LnBdd/hyberflow/index.md

---
title: Mainpage
nav_order: 1
---

<p align="center">
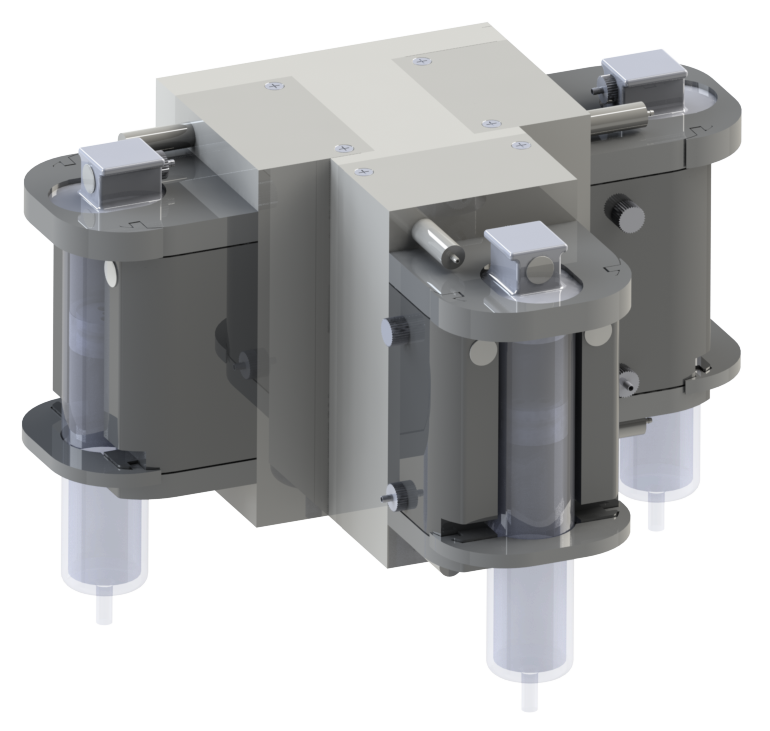
[picture p1: images/banner/Print_Head.png]
  
</p>

# HYBERFLOW - a novel hydraulically actuated open source bioextrusion printhead

HYBERFLOW is an printhead for bioextrusion applications and was developed at the Leibniz Universität Hannover by the [Institute for Mechatronic Systems](https://www.imes.uni-hannover.de/en/). 

This documentation enables you to rebuild the system and integrate it in your bioprinter setup. We provide an example code to interface the module through a serial commincation. Since the control of the actual extrusion of the module is done by an onboard microcontroller, mulitple modules can be interfaced and operated simultaniously. 

## Citing

The HYBERFLOW was first presented and evaluated in an [Bioprinting paper](https://www.sciencedirect.com/science/article/pii/S240588662500051X) in 2025, which is freely available. If you use parts of this project for your reserach, please cite the publication:
```
Leon Budde, Julia Hundertmark, Tim Meyer, Thomas Seel, Daniel O.M. Weber,
HYBERFLOW — enabling non-invasive flow rate feedback control in bioprinting via hydraulic actuation,
Bioprinting, Volume 50, 2025,
e00435,
ISSN 2405-8866,
https://doi.org/10.1016/j.bprint.2025.e00435.
```

## Further Publications

There are also further publication of our bioprinting and automation projects:
- [EMBC 2025 Camera-based In-Process Evaluation and Parameter Study of Core-Shell-Capsule Dimensions]()
- [CDBME 2024 Core-Shell Capsule Image Segmentation through Deep Learning with Synthetic Training Data](https://doi.org/10.1515/cdbme-2024-2030)
- [SLAS Tech 2024 CrocoGrip](https://doi.org/10.1016/j.slast.2024.100148)
- [CDBME 2022 A Six Degree of Freedom Bioprinter](https://www.degruyter.com/document/doi/10.1515/cdbme-2022-1036/html)
- more to come!

## Authors

HYBERFLOW is part of the PhD thesis of [Leon Budde](https://www.imes.uni-hannover.de/en/institut/team/m-sc-leon-budde)
(Email: <leon.budde@imes.uni-hannover.de>) and was developed with support from the IMES staff and supervised students.
