LnBdd/hyberflow/docs/Electronics.md

---
title: Electronics
parent: Assembly
nav_order: 1
---

<p align="left">
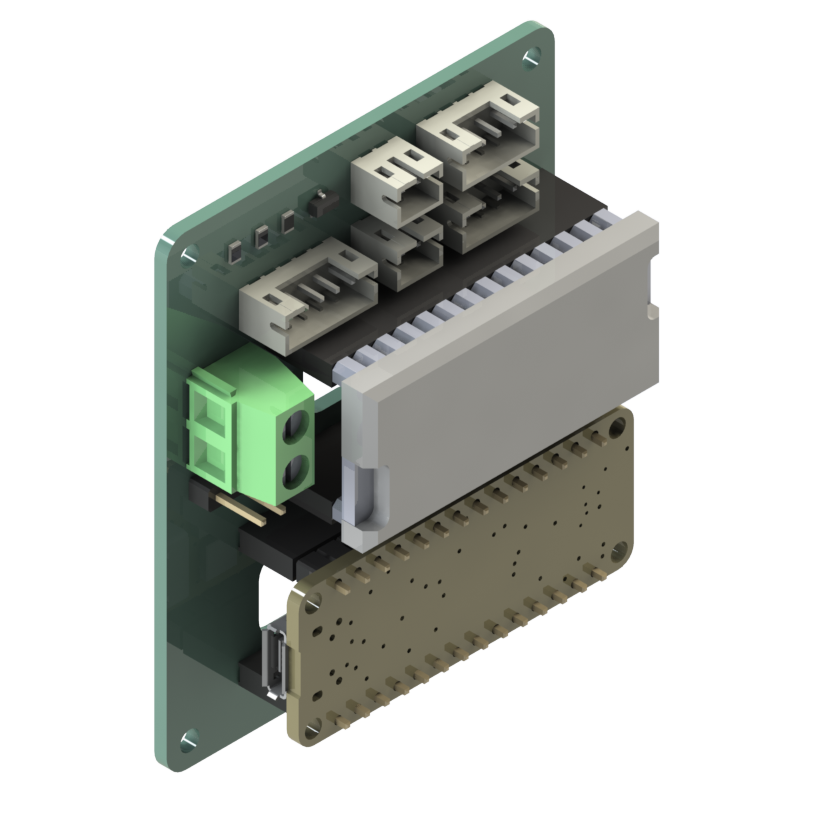
[picture p2: images/electronics/PCB_Iso.png]
  
</p>

<!-- Table of Contents -->
# Electronics
{: .no_toc }

## Table of Contents
{: .no_toc .text-delta }

1. TOC
{:toc}

{: .note }
The PCB can be downloaded [here](./Downloads/).

---

## Bill of Materials for PCB assembly

### Off-the-Shelf Components

| Part | Qty. | Manufacturer | Description / Value | Package | Type |
|---|---|---|---|---|---|
| Resistor | 3 | any | 4k7 | 805 | SMD |
| Connector | 2 | JST | B2B-PH-K-S | PH | THT |
| Connector | 2 | JST | PHR-2 | PH | THT |
| Connector | 1 | JST | PHR-3 | PH | THT |
| Connector | 2 | JST | B4B-PH-K-S | PH | THT |
| Connector | 2 | JST | PHR-4 | PH | THT |
| Connector | 1 | JST | B5B-PH-K-S | PH | THT |
| Connector | 1 | JST | PHR-5 | PH | THT |
| Crimp contact | 50 | JST | BPH-002T-P0.5S | PH | - |
| Connector | 1 | TE-Connectivity | 282836-2 | - | THT |
| MOSFET | 1 | ALPHA & OMEGA | AO3400A | SOT-32  | SMD |
| Pin Socket | 4 | any | 1×14 pin socket, 2.54mm pitch, vertical, 8.5mm height | - | THT |
| Pin Hocket | 1 | any | 1×02 pin header, 2.54mm pitch, vertical | - | THT |
| Jumper | 1 | any | 1×02 jumper, 2.54mm pitch, vertical | - | - |
| Wire | - | any | 0.25mm², different colors | - | - |
| Cable | 1 | Molex | Molex Picoblade 15134-0606 | - | - |

{: .note }
All other electrical components are listed [here](./ActuationUnit.md).

---

## PCB

### Schematics
<object data="../images/electronics/hyberflow_PCB_v1-2.pdf" width="800" height="600" type='application/pdf'></object>

### Pinout
<p align="center">
  
</p>

### Assembly 
For PCB assembly use the [interactive instructions](./Downloads.md).

---

## Wiring

{: .warning }
Cut the wires to a length that you are comfortable working with.
Bear in mind that crimp contacts can fail, so leave a safety margin for repair work.

{: .note }
The corresponding pins on the PCB and device connectors are labelled with the same names.

### Adafruit Metro Mini
<p align="center">
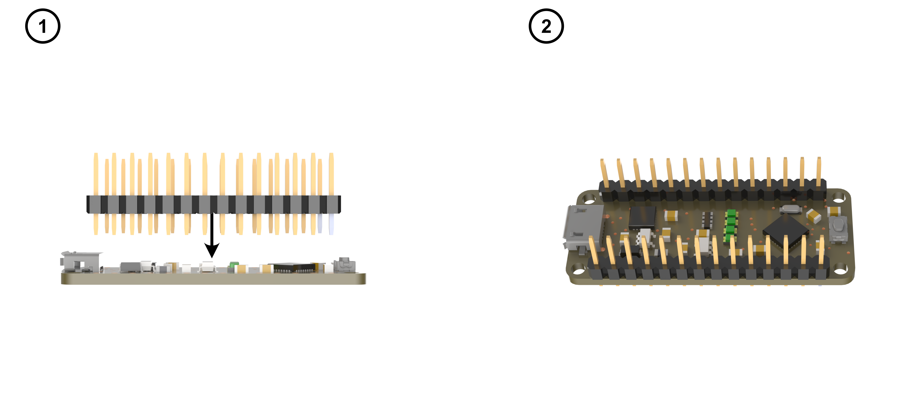
[picture p3: images/electronics/metroMini_assembly.png]
  
</p>

Solder the pinheaders to the Adafruit Metro Mini.

### Bartels Micropumps

<p align="center">
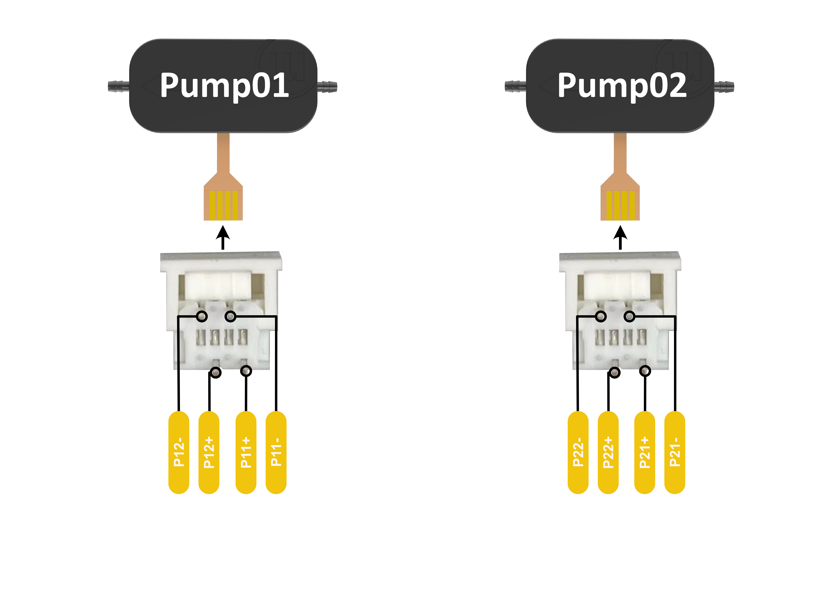
[picture p4: images/electronics/micropump_pinout.png]
  
  
</p>

Use JST-PH crimp contacts to crimp eight stranded wires (0.25mm²) at one end.
Combine 4 cables each in one JST-PH4 connector.
Solder the other ends to the micropump connector (supplied with the micro pump) as shown in the pictures.

{: .note }
Label the cables, so you can differentiate the two pumps later on.

### Sensorion Flowsensor

<p align="center">
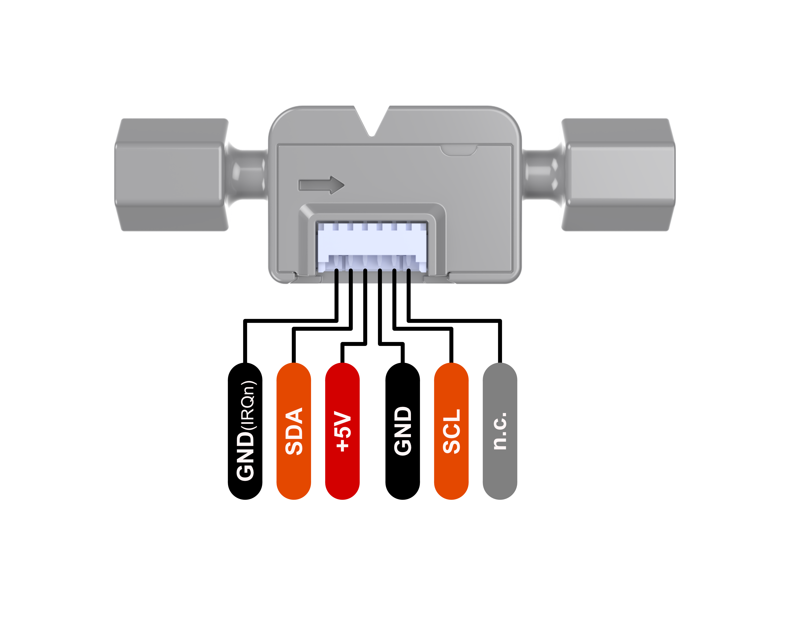
[picture p5: images/electronics/flowsensor_pinout.png]
  
  
</p>

Cut off one plug of the Molex Picoblade cable. Use 5 JST-PH crimp contacts to crimpt the cable, the n.c. cable can 
remain free.
Plug the 5 cables into one JST-PH5 connector as shows in the pictures.

### Staiger valves

<p align="center">
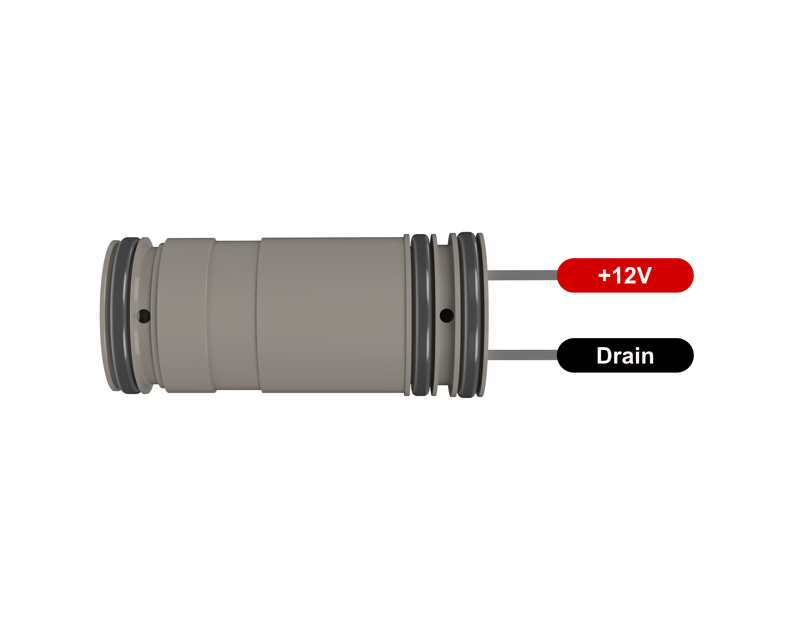
[picture p6: images/electronics/valve_pinout.png]
  
  
</p>

Use JST-PH crimp contacts to crimp four stranded wires (0.25mm²) at both ends.
Combine two cables in one JST-PH2 connector on the one side and in one JST-PH3 connector on the other.
Use the ports located at the edge.
The JST-PH3 connector is fits the pitch of the valve pins.
