LnBdd/hyberflow/docs/UnLoading.md

---
title: Loading & Unloading
parent: User Manual
nav_order: 2
---

<!-- Table of Contents -->
# User Manual for the HYBERFLOW
{: .no_toc }

## Table of Contents
{: .no_toc .text-delta }

1. TOC
{:toc}

<!--  -->

---

## Components

<p align="center">
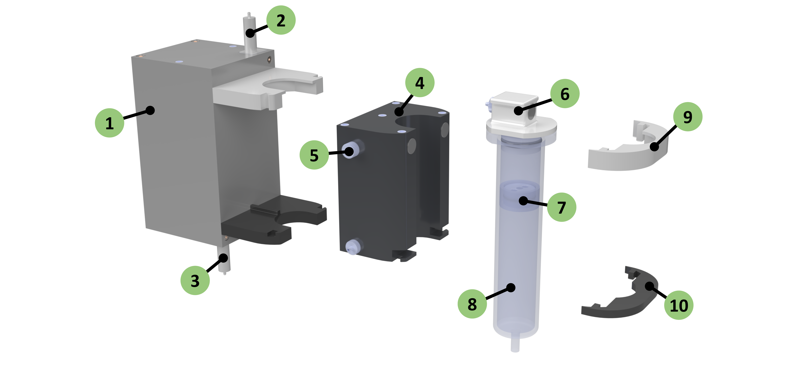
[picture p7: images/LoadingUnloading/loadingUnloading_overview.png]
  
</p>

| Part Number | Part |
|:---:|:---:|
|  **(01)** | Actuation unit |
|  **(02)** |  Upper quick release |
|  **(03)** |  Lower quick release |
|  **(04)** | Reservoir |
|  **(05)** | Filling port plug |
|  **(06)** | Syringe lid |
|  **(07)** | Divider |
|  **(08)** | Glasssyringe |
|  **(09)** | Upper fastener (white) |
|  **(10)** | Lower fastener (black) |

---

## Additional Tools & Materials

- Syringes for filling
- Bioink
- Actuation Fluid (i.e., sterile water)
- Tweezers 

---

## Loading 
{: .note }
For loading purposes the system can be operated dry.

Once the printing module has been assembled using the assembly instructions, the following steps are necessary to start a printing cycle.
<br>
1. Fill the reservoir **(4)** with the actuation fluid. Either unscrew the lid of the reservoir or use the filling port **(5)**. If you use the filling port, fill the reservoir slowly so that the pressure within the reservoir can be equalized thorugh the membrane.
2. Seal the outlet of the glasssyringe with a cap
3. Use an auxiallary syringe to fill the required amount of bioink into the glasssyringe **(1)**
4. Insert the divider **(2)** with the pressure equalizing membrane facing towards the bioink into the glassyringe **(1)**
5. Slowly push down the divider **(2)** using the tweezers
6. Fill the remaining volume of the glasssyringe **(1)** with sterile water until the water level is approximately 3 mm below the top edge of the glasssyringe
7. Fit the lid **(3)** to the syringe so that the orientation of the outer rim matches the rim of the glassyringe. Open the hose clip to let the additional water flow out.
8. No air should remain within the glasssyringe **(1)**. If the amount of water (see 6.) was not enough to fill the syringe completely, use another syringe to slowly add water to the system through the tube adapter until all air escaped through the pressure equalizing membrane
9. Fit the reservoir **(4)** to the actuation unit **(6)**
10. Connect the reservoir **(4)** to the actuation unit **(6)** using the lower quick release **(9)**
11. Fit the syringe **(1)** to the printing module
12. Secure the syringe **(1)** and the reservoir **(4)** using the two fasteners **(7 & 8)**
13. Connect the syringe **(4)** to the actuation unit using the upper quick release **(10)**
14. Ensure that the two hose clips (one between reservoir and actuation unit and one between actuation unit and syringe) are open

---

## Unloading

1. Close the two hose clips
2. Open both quick releases **(9 & 10)**
3. Remove the fasteners **(7 & 8)**
4. Remove the Syringe **(1)**
5. Remove the Reservoir **(4)**
6. Remove the lid of the syringe **(3)**
7. Use the tweezers to remove the divider **(2)** by grasping the two indents in the divider
8. Clean and sterilize all parts befor reusing them

---

## Video
[Show Video](https://github.com/LnBdd/hyberflow/blob/main/images/LoadingUnloading/Hydraulic_printing_module_mirrored.mp4)
