LnBdd/hyberflow/docs/Downloads.md

---
title: Downloads
nav_order: 5
---

# Downloads
{: .no_toc }

## Table of Contents
{: .no_toc .text-delta }

1. TOC
{:toc}

---

## 3D-Files

{: .note }
A possible arrangement of the models can be downloaded directly as a .3mf file.

- [STL Files](https://seafile.projekt.uni-hannover.de/f/e4122d421da94f3f80c9/?dl=1)
- [STEP Files](https://seafile.projekt.uni-hannover.de/f/4c3b1ebe9acc42ada274/?dl=1)
- [Full Project (Solidworks)](https://seafile.projekt.uni-hannover.de/f/7605b4c52d5544318a6a/?dl=1)
- [.3mf Files](https://seafile.projekt.uni-hannover.de/f/5b5ca7a2fcce4a918720/?dl=1)
- [.form Files](https://seafile.projekt.uni-hannover.de/f/a17966df0d364768874e/?dl=1)

---

## PCB
- [Gerberfiles for JLCPCB](https://seafile.projekt.uni-hannover.de/f/63af5b1bb9a84953a0af/?dl=1) <!-- Download muss erneuert werden -->
- [Full KiCad Project](https://seafile.projekt.uni-hannover.de/f/dfd6a07bc00e417d8d0a/?dl=1) <!-- Download muss erneuert werden -->
- [Assembly Instructions](https://seafile.projekt.uni-hannover.de/f/afa4dd5ba72e44d5bdd5/?dl=1)
  
---

## Software
- [Arduino Skript](../Code/arduino_control/arduino_control.ino)
- [GUI](../Code/GUI.py)
