LnBdd/hyberflow/Betrieb/main.md

---
title: Betriebsanleitung
has_children: true
nav_order: 3
---

# User Manual for the HYBERFLOW

<p align="center">
  
</p>

## Components

| Bauteil-Nr. | Name |
| :----: | :----: |
| **(1)** | Glasssyringe |
| **(2)** | Divider |
| **(3)** | Syringe lid |
| **(4)** | Reservoir |
| **(5)** | Filling port plug |
| **(6)** | Actuation unit |
| **(7)** | Upper fastener (white) |
| **(8)** | Lower fastener (black) |
| **(9)** | Lower quick release |
| **(10)** | Upper quick release |

## Additional Tools & Materials

- Syringes for filling
- Bioink
- Actuation Fluid (i.e., sterile water)
- Tweezers 

## Loading 

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

## Unloading

1. Close the two hose clips
2. Open both quick releases **(9 & 10)**
3. Remove the fasteners **(7 & 8)**
4. Remove the Syringe **(1)**
5. Remove the Reservoir **(4)**
6. Remove the lid of the syringe **(3)**
7. Use the tweezers to remove the divider **(2)** by grasping the two indents in the divider
8. Clean and sterilize all parts befor reusing them

## Video
[Video hier ansehen](https://github.com/LnBdd/hyberflow/blob/main/Abbildungen/Hydraulic_printing_module_mirrored.mp4)
