LnBdd/hyberflow/docs/GeneralDesignComponents.md

---
title: Manufacturing
parent: Manufacturing Instructions
nav_order: 1
---

# Manufacturing 
{: .no_toc }

This page gives a summary of all comonents that have to be 3D-printed or bought. 
The bill of materials is listed seperatly for each sub-assembly to sort the components before the assembly process. 
To simplify printing and ordering parts, the bottom of the page lists a [bill of materials](#summary-/-bill-of-materials) for the HYBERFLOW as a whole.

{: .note }
The 3D and PCB Files can be downloaded [here](./Downloads.md).

## Table of Contents
{: .no_toc .text-delta }

1. TOC
{:toc}

---

## Bill of Material

### Components for PCB

| Part Number | Part | Supplier | Quantity | 
| :----: | :----: | :----: | :----: |
| **(5)** | PCB | [Gerberfiles](https://seafile.cloud.uni-hannover.de/f/c398d5bc485c45f787d8/?dl=1) | 1 |
| **(6)** | mp-Highdriver4 | [Bartels Mikrotechnik](https://bartels-mikrotechnik.de/product/pump-driver/) | 1 |
| **(7)** | Adafruit Metro Mini| [Adafruit](https://www.adafruit.com/product/2590) | 1 |
<!-- Hier fehlt noch Litze -->

### Off-the-Shelf Components

| Part Number | Part | Supplier | Quantity | 
| :----: | :----: | :----: | :----: |
| **(1)** | Micropump mp6-liq | [Bartels Mikrotechnik](https://bartels-mikrotechnik.de/de/mikropumpen/) | 2 |
| **(2)** | mp-damper | [Bartels Mikrotechnik](https://bartels-mikrotechnik.de/product/mp-damper-pulsation-damper/) | 1 |
| **(3)** | Flow sensor SLF3S-0600F | [Sensirion](https://sensirion.com/de/produkte/katalog/SLF3S-0600F) | 1 |
| **(4)** | 3/2-way micro-switching valve | [Staiger](https://www.staiger.de/ventil-online-shop/start/mikroventile/va-304-913-v-08-sap-12-1-detail) | 2 |
| **(5)** | PCB |  | 1 |
| **(6)** | mp-Highdriver4 | [Bartels Mikrotechnik](https://bartels-mikrotechnik.de/product/pump-driver/) | 1 |
| **(7)** | Adafruit Metro Mini| [Adafruit](https://www.adafruit.com/product/2590) | 1 |
| **(15)** | Thread insert | [Ruthex](https://www.ruthex.de/products/ruthex-gewindeeinsatz-m2-70-stuck-rx-m2x4-messing-gewindebuchsen) | 4 |
| **(16)** | Hydraulic quick release | [Lesu](https://www.scm-modellbau.com/Lesu-Schnellkupplung-2-x-1-mm-Schlauch-M3-Gewinde) | 2 |
| **(17)** | Pressure equalising membrane | [Schreiner Group](https://www.schreiner-group.com/de/produkte/technische-industrie/druckausgleichselemente) | 4 |
| **(18)** | O-Ring 11,6x2,4 | [IR Dichtungstechnik](https://www.ir-dichtungstechnik.de/gewerbe/de/o-ring-11-6-x-2-4-mm-nbr-70-5-shore-a-schwarz-black-33423.html) | 1 |
| **(19)** | O-Ring 15,3x2,4 |[IR Dichtungstechnik](https://www.ir-dichtungstechnik.de/gewerbe/de/o-ring-15-3-x-2-4-mm-nbr-70-5-shore-a-schwarz-black-32113.html) | 1 |
| **(20)** | O-Ring 4x1 |[IR Dichtungstechnik](https://www.ir-dichtungstechnik.de/gewerbe/de/o-ring-4-0-x-1-0-mm-fkm-80-5-shore-a-schwarz-black.html) | 1 |
| **(21)** | Glasssyringe | [Poulten & Graf](https://poulten-graf.de/produkt/ganzglasspritze-fortuna-optima-20-ml-10-ml-glasspitze-luer/) | 1 |
| **(32)** | Tubing | [Bartels Mikrotechnik](https://bartels-mikrotechnik.de/product/mp-t-tygon-tubing/) | 50 cm |
| **(33)** | Hose clamp | [Bartels Mikrotechnik](https://bartels-mikrotechnik.de/product/mp-hc-hose-clamp/) | 18 |
| **(34)** | Y-Hose connector | [Bartels Mikrotechnik](https://bartels-mikrotechnik.de/product/mp-y-hose-connector/) | 2 |
| **(35)** | Hose clip | [Bürkle](https://www.buerkle.de/de/schlauchklemme-quetsch-fix_p8618-0001) | 2 |
| **(36)** | Countersunk head screw M2,5x4 | any | 2 |
| **(37)** | Cylinder head screw M1,6x8 | any | 10 |
| **(38)** | Cylinder head screw M2x8 | any | 8 |
| **(39)** | Cylinder head screw M2x16 | any | 4 |
| **(40)** | Cylinder head screw M2,5x8 | any | 9 |

### 3D Printed Components

| Material | File | Quantity | 
| :----: | :----: | :----: |
| PLA | cover.stl | 1 |
| PLA | upper_support.stl | 1 |
| PLA | lower_support.stl | 1 |
| PLA | upper_fastener.stl | 1 |
| PLA | lower_fastener.stl | 1 |
| PLA | back_wall.stl | 1 |
| PLA | micropump_frame_A.stl | 1 |
| PLA | micropump_frame_B.stl | 1 |
| PLA | damper_frame.stl | 1 |
| PLA | connectorSleeve.stl | 1 |
| MED610 | reservoir.stl | 1 |
| MED610 | fillig_port_plug.stl | 1 |
| MED610 | divider.stl | 1 |
| MED610 | syringe_cap.stl | 1 |
| MED610 | tube_adapter.stl | 4 |
| MED610 | tubeConnector-adapter | 2 |
| MED610 | valve_interface.stl | 2 |
| MED610 | tube_adapter.stl | 6 |
| MED610 <br> Agilus30 | reservoir_lid.stl | 1 |

---

## Print Orientation

### FDM Print
<p align="center">
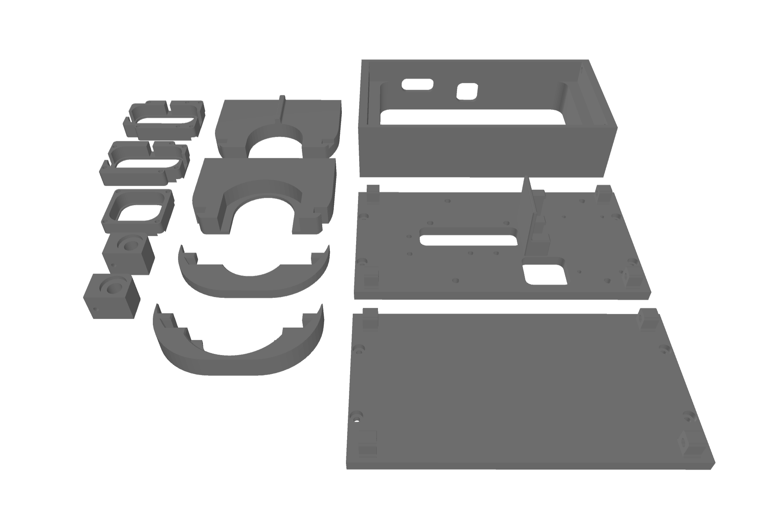
[picture p31: Abbildungen/manufacturing/fdm_print-orientation.png]
  
</p>

#### Print Settings:
- Layer height: 0.2mm
- Infill: 15%
- Perimeter: 5
- Supports: enabled
- Brim ears: only for large, rectangular parts to prevent warping
