LnBdd/hyberflow/docs/Assembly.md

---
title: Assembly
has_children: true
parent: Manufacturing Instructions
nav_order: 2
---

# Assembly Instructions
