LnBdd/hyberflow/docs/UserManual.md

---
title: User Manual
has_children: true
nav_order: 3
---

# User Manual
