LnBdd/hyberflow/(threads)

Thread 9 (2024-11-20):

GUI implementieren

LnBdd, 2024-11-20:
Simple GUI, die:

- Start / Stopp Button hat
- Schieberegler zum Einstellen des Soll durchfluss
- KP, KI eingegeben werden könne
- Kleine Visualisierung der aktuellen Durchflussmenge als kontinuierlicher Graph

Closed 2025-05-13.

Thread 17 (2025-05-27):

Assembly Hyperflow + Render

hadele, 2025-05-27:
**CAD-Dateien**
https://seafile.cloud.uni-hannover.de/d/a1415462fcf54b4eafae/

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

- [ ] Anbau Lüftungsmembran, habe keine mehr gefunden -> ggf. bestellen

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

- [ ]  Stopfen von Julia passt nicht, ggf. erstmal Stopfen von CrocoGrip Greifer verwenden?
- [ ] Datei von Deckel fehlt, muss nachmodelliert werden - bisher keine Antwort von Julia - vermutlich unterwegs
- [ ] Bei Schlauchverbinder fehlen noch die Dichtungsringe im Modell

**Render**

- Die Explosionsansichten von Julia sind noch im Projekt hinterlegt
- Render Settings: Default
- Abstand von Ground Plane erhöhen um Schatten zu entfernen - ggf. gibt es auch eine geeignetere Methode
- Neuen Schlauchverbinder + PCB in Explosionsansicht verschieben

Thread 20 (2025-07-30):

Reviewer 1

LnBdd, 2025-07-30:
- [x] Although the manuscript claims superiority over existing pneumatic systems, no direct side-by-side comparison (e.g., printing accuracy, cell viability, setup time) is made with commercial or other academic systems. Adding comparative performance data with at least one existing flow-controlled pneumatic system or discuss specific metrics (e.g., print fidelity, reproducibility, flow rate variation) in a table or plot will be very helpful.
- [x]  The system is designed for bioprinting, yet there is no experimental validation involving living cells, despite potential concerns about viability due to pressure or flow irregularities. At minimum, including a viability test (even basic cell survival) or clearly stating when and how this evaluation will be addressed, is important.
- [x] The paper acknowledges that micropumps provide discrete rather than continuous control, causing oscillations and non-linear behaviors. While mitigated with a PI controller, the issue remains substantial, especially for high-precision applications. Any quantify the flow rate fluctuation with and without control?
- [x] While the control strategy is conceptually described, the algorithm, tuning process, and control logic lack formal detail. This reduces clarity and reproducibility for readers intending to replicate the method. Please include a control algorithm pseudocode or flowchart and describe parameter tuning methodology in detail, possibly in supplementary materials.
- [x] The printed lattice pattern is only qualitatively discussed. However, print resolution, uniformity, dimensional accuracy, and fiber width variability are not quantified, which limits the strength of claims about improved print quality. Can the authors add at least one such metric to claim about the print quality?

LnBdd, 2025-07-31:
> The system is designed for bioprinting, yet there is no experimental validation involving living cells, despite potential concerns about viability due to pressure or flow irregularities. At minimum, including a viability test (even basic cell survival) or clearly stating when and how this evaluation will be addressed, is important.

Valid point. We will conduct a side-by-side comparison regarding cell viability in the near future. As the basic principle of working is identical to well-established pneumatic bioextruders (that is, pressurizing one chamber of a syringe to move a divider for the extrusion), we believe the HYBERFLOW to perform similarly to pneumatic systems. Moreover, there will be fewer changes in flow rate compared to pneumatic systems, as we can maintain a constant flow rate through the feedback control. Whether a (more) constant flow rate significantly affects cell viability remains to be seen in additional experiments. However, as literature and our experiments showed, a constant flow rate improves the printing quality. This improved printing quality is the main reason for us to opt for flow rate-controlled extrusions.

LnBdd, 2025-07-31:
> The paper acknowledges that micropumps provide discrete rather than continuous control, causing oscillations and non-linear behaviors. While mitigated with a PI controller, the issue remains substantial, especially for high-precision applications. Any quantify the flow rate fluctuation with and without control?

Yes, the odd behaviour of the pumps remains a problem. However, the results (Fig. XX and XX) show that the feedback control is able to achieve an accuracy of XX over time. Without the feedback control (pump settings remain constant) the accuracy is much lower XX.

Closed 2025-08-07.
