LnBdd/hyberflow/images/electronics/hyberflow_PCB_v1-2.pdf

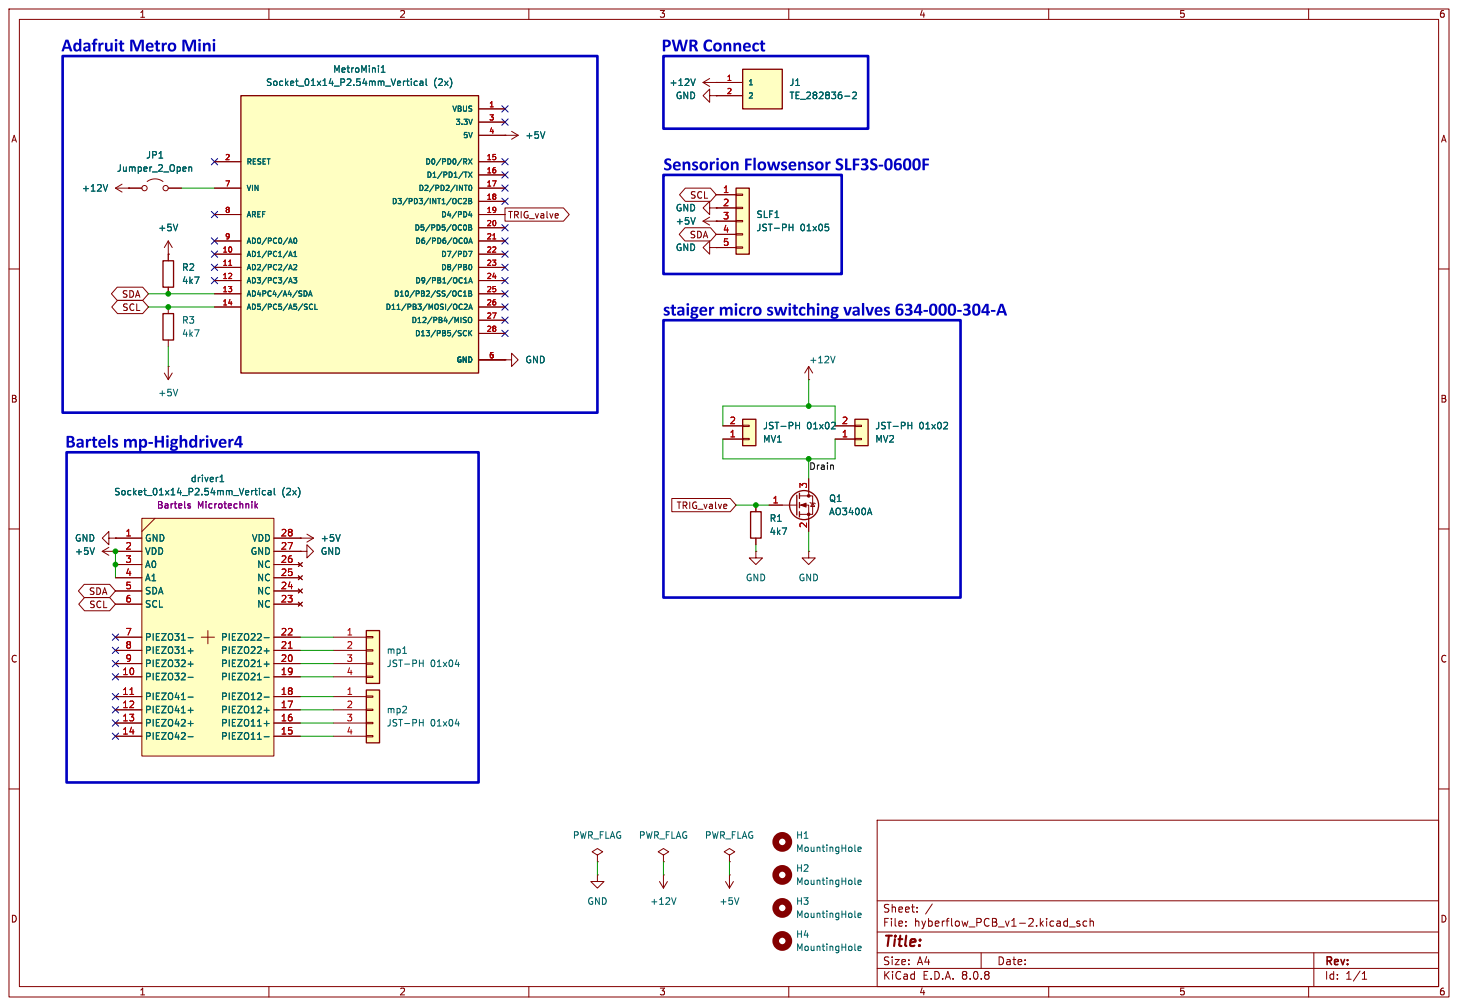
[picture p32: page 1]
