LnBdd/hyberflow/(commit log)

2025-05-30 Added PCB files and renders
2025-07-29 In progress: updated electronics, added pcb schematics, moved electronic drawings from GeneralDesignComponents to Electronics
2025-08-01 In progress: updated wiring illustrations
2025-08-01 added print orientation for fdm print
2025-08-04 ongoing: electronics wiring
2025-08-04 ongoing: added wiring instructios
2025-08-04 moved BOM to each subcategory
2025-08-05 ongoing: updateing BOM
2025-08-15 ongoing: update bom
2025-08-18 update Actuation Unit: BOM
2025-08-18 update Actuation Unit: added missing Parts to BOM
2025-08-18 update BioCart: BOM
2025-08-19 update componentOverview: picture fdm print
2025-08-19 update: component overview - pcb manufacturing guidlines
2025-08-20 Inserted Links
2025-08-26 Inserted Full-Project Link
